S0nFra/AirMouse/Core/Src/main.c

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
/* Includes ------------------------------------------------------------------*/
#include "main.h"
#include "cmsis_os.h"
#include "fatfs.h"
#include "i2c.h"
#include "spi.h"
#include "usart.h"
#include "gpio.h"

/* USER CODE BEGIN Includes */
#include "mpu6050.h"
#include "ds3231.h"
#include "File_Handling_RTOS.h"
#include "printf.h"
/* USER CODE END Includes */


/* USER CODE BEGIN PV */

/* Variables of the two MPU6050 on index hand and thumb */
MPU6050 mpu_ind;
MPU6050 mpu_pol;

/* Useful variables for file management declared in File_Handling_RTOS.c */
extern FIL fil; // File
extern UINT br, bw;  // File read/write count

/* USER CODE END PV */

void SystemClock_Config(void);
void MX_FREERTOS_Init(void);
/**
  * @brief  The application entry point.
  * @retval int
  */
int main(void)
{
  /* MCU Configuration--------------------------------------------------------*/

  /* Reset of all peripherals, Initializes the Flash interface and the Systick. */
  HAL_Init();

  /* Configure the system clock */
  SystemClock_Config();

  /* Initialize all configured peripherals */
  MX_GPIO_Init();
  MX_I2C1_Init();
  MX_USART2_Init();
  MX_I2C2_Init();
  MX_SPI3_Init();
  MX_FATFS_Init();
  /* USER CODE BEGIN 2 */

	/* Wait for system inizialization */
	HAL_Delay(2000);
	/* Mount the SD card */
	while (Mount_SD("/") != FR_OK);
	/* Initialize the DS3231 RTC on I2C2 */
	while (rtc_init(&hi2c2) != DS3231_OK);
	/* Initialize the MPU6050 on index hand on I2C1 */
	while (MPU6050_Init(&hi2c1, &mpu_ind, MPU6050_Device_0,
			MPU6050_Accelerometer_16G, MPU6050_Gyroscope_250s)
			!= MPU6050_Result_Ok);
	/* Initialize the MPU6050 on thumb on I2C1 */
	while (MPU6050_Init(&hi2c1, &mpu_pol, MPU6050_Device_1,
			MPU6050_Accelerometer_16G, MPU6050_Gyroscope_250s)
			!= MPU6050_Result_Ok);
	/* Get the current time from RTC and create a log file named as "dd_mm_yy.TXT" */
	date_time_t datetime;
	rtc_get_date_time(&datetime);
	char filename[50];
	sprintf(filename, "%d_%d_%d.TXT", datetime.date, datetime.month, datetime.year);
	while (Create_File(filename) != FR_OK);
	/* Open the file created for command log on SD card */
	while (f_open(&fil, filename, FA_OPEN_APPEND | FA_WRITE) != FR_OK) {
		char buf[60];
		sprintf(buf, "ERROR!!! *%s* does not exists\n\n", filename);
		HAL_USART_Transmit(&husart2, (uint8_t*) buf, sizeof(char) * strlen(buf),
		HAL_MAX_DELAY);
	}
	/* Turn on the pin on MCU in order to nofity the correct end of the inizialization phase */
	HAL_GPIO_WritePin(LED_GPIO_Port, LED_Pin, 1);

  /* USER CODE END 2 */

  /* Init scheduler */
  osKernelInitialize();  /* Call init function for freertos objects (in freertos.c) */
  MX_FREERTOS_Init();

  /* Start scheduler */
  osKernelStart();

  /* We should never get here as control is now taken by the scheduler */
  /* Infinite loop */
  /* USER CODE BEGIN WHILE */
	while (1) {
    /* USER CODE END WHILE */

    /* USER CODE BEGIN 3 */
	}
  /* USER CODE END 3 */
}

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
/**
  * @brief  Period elapsed callback in non blocking mode
  * @note   This function is called  when TIM9 interrupt took place, inside
  * HAL_TIM_IRQHandler(). It makes a direct call to HAL_IncTick() to increment
  * a global variable "uwTick" used as application time base.
  * @param  htim : TIM handle
  * @retval None
  */
void HAL_TIM_PeriodElapsedCallback(TIM_HandleTypeDef *htim)
{
  if (htim->Instance == TIM9) {
    HAL_IncTick();
  }
}

/**
  * @brief  This function is executed in case of error occurrence.
  * @retval None
  */
void Error_Handler(void)
{
  /* USER CODE BEGIN Error_Handler_Debug */
	/* User can add his own implementation to report the HAL error return state */
	__disable_irq();
	while (1) {
	}
  /* USER CODE END Error_Handler_Debug */
}

#ifdef  USE_FULL_ASSERT
/**
  * @brief  Reports the name of the source file and the source line number
  *         where the assert_param error has occurred.
  * @param  file: pointer to the source file name
  * @param  line: assert_param error line source number
  * @retval None
  */
void assert_failed(uint8_t *file, uint32_t line)
{
  /* USER CODE BEGIN 6 */
  /* User can add his own implementation to report the file name and line number,
     ex: printf("Wrong parameters value: file %s on line %d\r\n", file, line) */
  /* USER CODE END 6 */
}
#endif /* USE_FULL_ASSERT */
